MuonPi/cosmic-detector-unit-lite/README.md

# cosmic-detector-unit-lite

simplified version of the Muonpi-HAT-Board

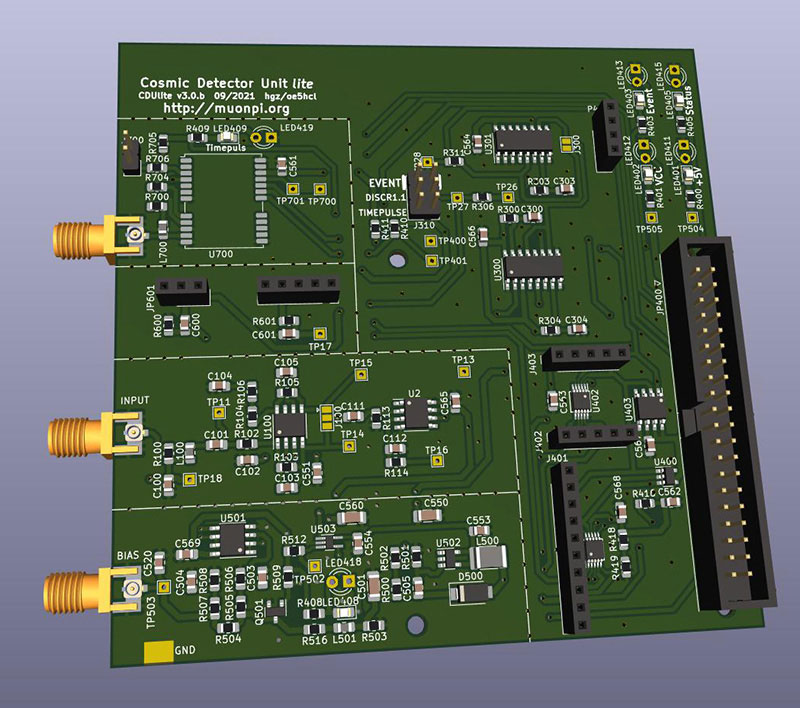
[picture p1: images/cdu-lite-3_0_b-1.jpg]
cdu-lite 3.0


License CC-BY-SA 3.0
