MuonPi/cosmic-detector-unit-lite/images/cdu-lite-3_0_b-2.jpg

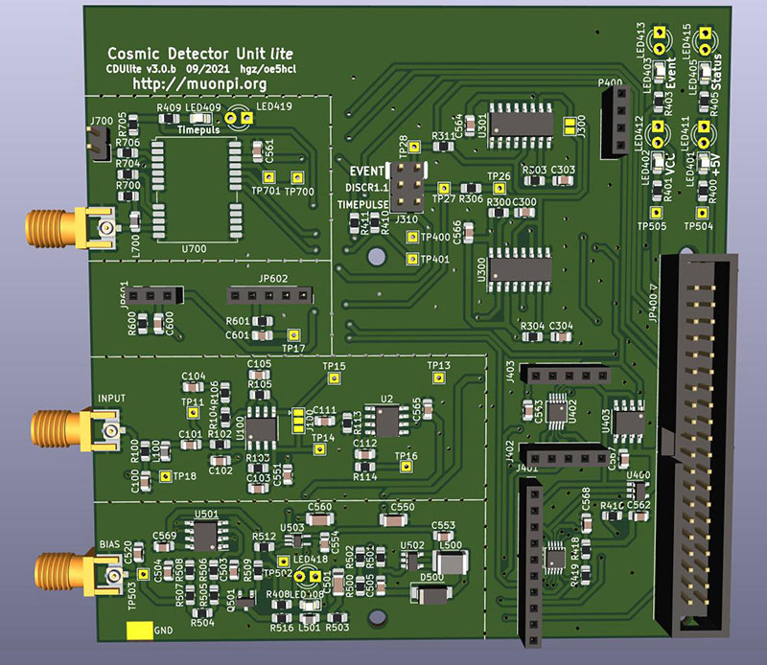
images/cdu-lite-3_0_b-2.jpg
