MuonPi/cosmic-detector-unit-lite/bom.xlsx

Sheet: cdu-lite Notes
BOM for the Cosmic Detector Unite Lite v3.0.b 11/2021
Some of the components were assembled by JLCpcb during production.
These components can be found in the list "cdu-lite parts Placed by JLC".
The remaining components can be found in the list "cdu-lite final assembly"
Additional Component which you need to operate the Muon Detector are listed in "additional components"

Sheet: cdu-lite Parts Placed by JLC
Ref | Qnty | Value | Footprint | Supplier | OriginalType | Preplaces By JLC | JLC Type | JLC Part Number
C100 C102 C112 C304 C551 C553 C554 C561 C562 C563 C564 C565 C566 C567 C569 | 15 | 100n | Capacitor_SMD:C_0805_2012Metric_Pad1.18x1.45mm_HandSolder | LCSC | FN21X104K500PXG | yes | CC0805KRX7R9BB104 | C49678
C101 C104 | 2 | 220p | Capacitor_SMD:C_0805_2012Metric_Pad1.18x1.45mm_HandSolder | LCSC | TCC0805X7R221K500DT | yes | CL21B221KBANNNC | C53172
C103 C105 | 2 | 2p2 | Capacitor_SMD:C_0805_2012Metric_Pad1.18x1.45mm_HandSolder | LCSC | TCC0805COG2R2C500BT | yes | 0805CG2R2C500NT | C1801
C111 C520 C600 C601 | 4 | 10n | Capacitor_SMD:C_0805_2012Metric_Pad1.18x1.45mm_HandSolder | LCSC | GRM216R71H103KA01D | yes | CL21B103KBANNNC | C1710
C300 | 1 | 33p | Capacitor_SMD:C_0805_2012Metric_Pad1.18x1.45mm_HandSolder | LCSC | TCC0805COG330J500BT | yes | CL21C330JBANNNC | C1814
C303 C503 C504 | 3 | 1n | Capacitor_SMD:C_0805_2012Metric_Pad1.18x1.45mm_HandSolder | LCSC | 0805B102K500CT | yes | CL21B102KBCNNNC | C46653
C501 C550 C560 | 3 | 4u7/50V X7R | Capacitor_SMD:C_1206_3216Metric_Pad1.33x1.80mm_HandSolder | LCSC | GRM31CR71H475KA12L | yes | 1206B475K500NT | C29823
C505 | 1 | 150p | Capacitor_SMD:C_0805_2012Metric_Pad1.18x1.45mm_HandSolder | LCSC | TCC0805X7R151K500BT | yes | 0805B151K500NT | C1716
C568 | 1 | 1u | Capacitor_SMD:C_0805_2012Metric_Pad1.18x1.45mm_HandSolder | LCSC | CL21B105KBFNNNE | yes | CL21B105KBFNNNE | C28323
L700 | 1 | 27nH | Inductor_SMD:L_0805_2012Metric_Pad1.15x1.40mm_HandSolder | LCSC | VHF201209H27NJT | yes | MLI2012-27N(f) | C56586
LED401 | 1 | +5V (yellow) | LED_SMD:LED_0805_2012Metric_Pad1.15x1.40mm_HandSolder | LCSC | E6C0805UYAC1UDA | yes | C2296 (yellow) | C2297
LED402 | 1 | VCC (yellow) | LED_SMD:LED_0805_2012Metric_Pad1.15x1.40mm_HandSolder | LCSC | E6C0805UYAC1UDA | yes | C2296 (yellow) | C2297
LED403 | 1 | CH1 (blue) | LED_SMD:LED_0805_2012Metric_Pad1.15x1.40mm_HandSolder | LCSC | 17-21/BHC-XL2M2TY/3T | yes | C2293 (red) | C84256
LED405 | 1 | St1 (green) | LED_SMD:LED_0805_2012Metric_Pad1.15x1.40mm_HandSolder | LCSC | ORH-G35A | yes | C2297 (green) | C2297
LED408 | 1 | BiasEn (red) | LED_SMD:LED_0805_2012Metric_Pad1.15x1.40mm_HandSolder | LCSC | 17-21SURC/S530-A3/TR8 | yes | NCD0805R1 (red) | C84256
LED409 | 1 | TimeP (white) | LED_SMD:LED_0805_2012Metric_Pad1.15x1.40mm_HandSolder | LCSC | ORH-W45A | yes | C34499 (white) | C84256
Q501 | 1 | 2N7002 | Package_TO_SOT_SMD:SOT-23 | LCSC | C8545 | yes | 2N7002 | C8545
R100 R306 R311 R705 R706 | 5 | 51R | Resistor_SMD:R_0805_2012Metric_Pad1.20x1.40mm_HandSolder | LCSC | CR0805J80510G | yes | 0805W8F510JT5E | C17738
R102 R104 R300 R303 R601 | 5 | 1k | Resistor_SMD:R_0805_2012Metric_Pad1.20x1.40mm_HandSolder | LCSC | AR05FTDW1001 | yes | 0805W8F1001T5E | C17513
R103 R105 R400 R403 | 4 | 2k7 | Resistor_SMD:R_0805_2012Metric_Pad1.20x1.40mm_HandSolder | LCSC | RS-05K2701FT | yes | 0805W8F2701T5E | C17530
R106 | 1 | 27R | Resistor_SMD:R_0805_2012Metric_Pad1.20x1.40mm_HandSolder | LCSC | CR0805F827R0G | yes | 0805W8F270JT5E | C17594
R113 R418 R419 R504 R509 R512 R516 R600 | 8 | 10k | Resistor_SMD:R_0805_2012Metric_Pad1.20x1.40mm_HandSolder | LCSC | WR08X1002FTL | yes | 0805W8F1002T5E | C17414
R114 | 1 | 100 | Resistor_SMD:R_0805_2012Metric_Pad1.20x1.40mm_HandSolder | LCSC | 0805W8F1000T5E | yes | 0805W8F1000T5E | C17408
R304 | 1 | 470k | Resistor_SMD:R_0805_2012Metric_Pad1.20x1.40mm_HandSolder | LCSC | RS-05K4703FT | yes | 0805W8F4703T5E | C17709
R401 | 1 | 1k8 | Resistor_SMD:R_0805_2012Metric_Pad1.20x1.40mm_HandSolder | LCSC | -- | yes | 0805W8F1801T5E | C17398
R405 R409 | 2 | 3k6 | Resistor_SMD:R_0805_2012Metric_Pad1.20x1.40mm_HandSolder | LCSC | -- | yes | 0805W8F3601T5E | C18359
R408 | 1 | 2k2 | Resistor_SMD:R_0805_2012Metric_Pad1.20x1.40mm_HandSolder | LCSC | -- | yes | 0805W8F2201T5E | C17520
R410 R411 R416 R503 | 4 | 4k7 | Resistor_SMD:R_0805_2012Metric_Pad1.20x1.40mm_HandSolder | LCSC | RK73B2ATTD472J | yes | 0805W8F4701T5E | C17673
R500 | 1 | 220k | Resistor_SMD:R_0805_2012Metric_Pad1.20x1.40mm_HandSolder | LCSC | RS-05K224JT | yes | 0805W8F2203T5E | C17556
R501 | 1 | 13k | Resistor_SMD:R_0805_2012Metric_Pad1.20x1.40mm_HandSolder | LCSC | 0805W8F1302T5E | yes | 0805W8F1302T5E | C17455
R502 | 1 | 22k | Resistor_SMD:R_0805_2012Metric_Pad1.20x1.40mm_HandSolder | LCSC | 0805W8F2202T5E | yes | 0805W8F2202T5E | C17560
R505 R507 | 2 | 10M | Resistor_SMD:R_0805_2012Metric_Pad1.20x1.40mm_HandSolder | LCSC | RTT051005FTP | yes | 0805W8F1005T5E | C26108
R506 R508 | 2 | 1M | Resistor_SMD:R_0805_2012Metric_Pad1.20x1.40mm_HandSolder | LCSC | RS-05K1004FT | yes | 0805W8F1004T5E | C17514
R700 | 1 | 10R | Resistor_SMD:R_0805_2012Metric_Pad1.20x1.40mm_HandSolder | LCSC | RK73H2ATTD10R0F | yes | 0805W8F100JT5E | C17415
R704 | 1 | 0R | Resistor_SMD:R_0805_2012Metric_Pad1.20x1.40mm_HandSolder | LCSC | -- | yes | 0805W8F0000T5E | C17477
U100 | 1 | LMH6550MAX_NOPE | muonpi-kicad-library:SOIC-8_3.9x4.9mm_P1.27mm | LCSC | 926-LMH6550MAX/NOPB | yes | LMH6550MA/NOPB | C205894
U403 | 1 | LM75BIM-3 | Package_SO:SOIC-8_3.9x4.9mm_P1.27mm | LCSC | C34565 | yes | M75BD,118 | C34565
U502 | 1 | LM2733YMFX/NOPB | Package_TO_SOT_SMD:SOT-23-5 | LCSC | LM2733YMFX/NOPB | yes | LM2733YMFX/NOPB | C527399

Sheet: cdu-lite final assembly
Ref |  | Qnty | Value | Footprint | Supplier | Type
L100 L501 |  | 2 | 1uH | Inductor_SMD:L_0805_2012Metric_Pad1.15x1.40mm_HandSolder | Mouser | L-15F1R0JV4E
L500 |  | 1 | 10uH | Inductor_SMD:L_1812_4532Metric_Pad1.30x3.40mm_HandSolder | Mouser | LQH43MN100J03L
U2 |  | 1 | TLV3501AID | Package_SO:SOIC-8_3.9x4.9mm_P1.27mm | Mouser | 595-TLV3501AID
U300 U301 |  | 2 | SN74LV221AD | Package_SO:SOIC-16_3.9x9.9mm_P1.27mm | Mouser | 595-SN74LV221ADR
U400 |  | 1 | 24AA02UIDT-IOT | Package_TO_SOT_SMD:SOT-23-5 | Mouser | 579-24AA02UIDT-I/OT
U501 |  | 1 | MCP6L02x-xSN | Package_SO:SOIC-8_3.9x4.9mm_P1.27mm | Mouser | 579-MCP6L02T-E/SN
U503 |  | 1 | TPS22944DCKR | Package_TO_SOT_SMD:SOT-353_SC-70-5_Handsoldering | Mouser | 595-TPS22944DCKR
U700 |  | 1 | ublox NEO-6P | muonpi-kicad-library:ublox_NEO | -- |  | Note: NEO-6/7/8/9 are pin compatible und supported.
X1 X5 |  | 2 | Conn_Coaxial | muonpi-kicad-library:Connector_Coaxial_SMA_edge_combined | LCSC | U.FL-R-SMT-1(80)
J310 |  | 1 | Conn_02x03_Odd_Even | Connector_PinHeader_2.54mm:PinHeader_2x03_P2.54mm_Vertical | Mouser | 649-1012938190601BLF
to J310 |  | 1 | Jumper RM 2.54 |  | Mouser | 861410021H12LF
X7 |  | 1 | U.FL-R-SMT-1(80) | muonpi-kicad-library:Connector_Coaxial_SMA_edge_combined | LCSC | U.FL-R-SMT-1(80)
 | or | 1 | SMA Female |  | -- | SMA Female Connector for PCB Edge Mount
D500 |  | 1 | MBRA160T3G | Diode_SMD:D_SMA | LCSC | MBRA160T3G
 | or | 1 | B160AF-13 | Diode_SMD:D_SMA | Mouser | B160AF-13
JP400 |  | 1 | ICD Header 2x20 RM 2.54 | Connector_IDC:IDC-Header_2x20_P2.54mm_Vertical | --
 | or | 1 | Conn_02x20 | Connector_PinSocket_2.54mm:PinSocket_2x20_P2.54mm_Vertical | --
U401 |  | 1 | ADS1015IDGSR | Package_SO:TSSOP-10_3x3mm_P0.5mm | Mouser | 595-ADS1015IDGSR
 | or
J401 |  | 1 | Conn_01x10_Female | Connector_PinSocket_2.54mm:PinSocket_1x10_P2.54mm_Vertical | --
U401 breakout |  | 1 | ADS1015 Breakout Board
U402 |  | 1 | MCP4728_EUN | Package_SO:MSOP-10_3x3mm_P0.5mm | Mouser | 579-MCP4728-E/UN
 | or
J402 J403 |  | 2 | Conn_01x06_Female | Connector_PinSocket_2.54mm:PinSocket_1x06_P2.54mm_Vertical | --
U402 breakout |  | 1 | Adafruit MCP4728 Breakout
optional if you want to use a I2C Oled Display
P400 |  | 1 | Conn_01x04_Female | Connector_PinSocket_2.54mm:PinSocket_1x04_P2.54mm_Vertical | --
 |  | 1 | I2C Oled Display
optional if you want to add a Peak Detector
JP601 |  | 1 | Conn_01x03_Female | Connector_PinSocket_2.54mm:PinSocket_1x03_P2.54mm_Vertical | --
JP602 |  | 1 | Conn_01x05_Female | Connector_PinSocket_2.54mm:PinSocket_1x05_P2.54mm_Vertical | --

Sheet: Aditional components
qty | Description
1 | Raspberry Pi with 40 Pin GPIO Header (e.g. Raspberry Pi 3 or 4 // Raspberry Pi Zero (W))
1 | SD Card for Raspberry Pi (with Raspberry PI OS recommended)
1 | Power Supply for Raspberry Pi
1 | GPS Antenna
1 | 40 pin ribbon-cable with 2x20 RM2.54 female connector
1 | Scintillation detector from the Muonpi Project
2 | U.FL -> U.FL female cable
