MuonPi/cosmic-detector-unit-lite/pdf/cdu-lite.pdf

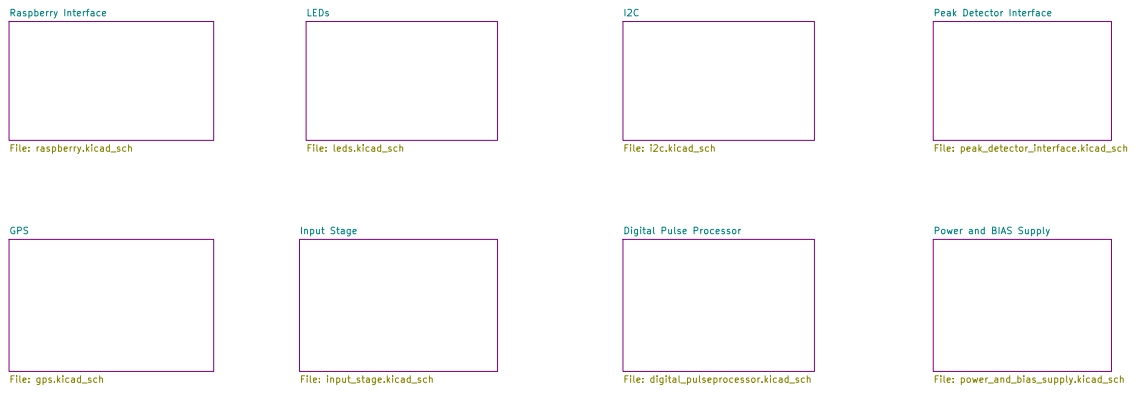
[picture p3: page 1]

Power and BIAS Supply

File: cdu-lite.kicad_sch Sheet: /
Id: 1/9 Title:

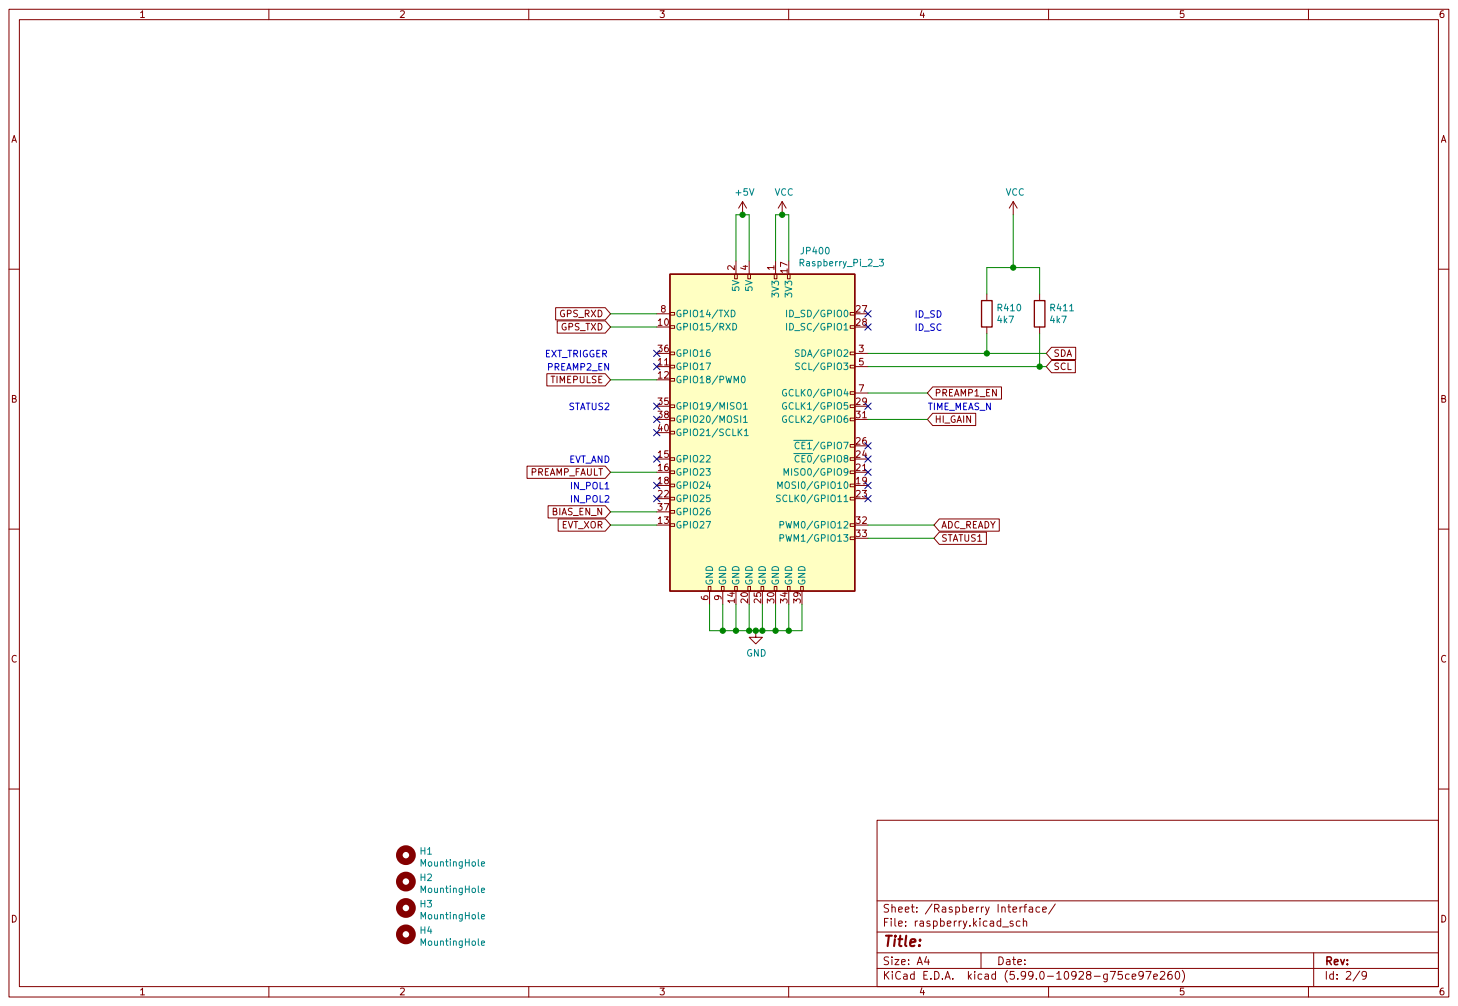
[picture p4: page 2]

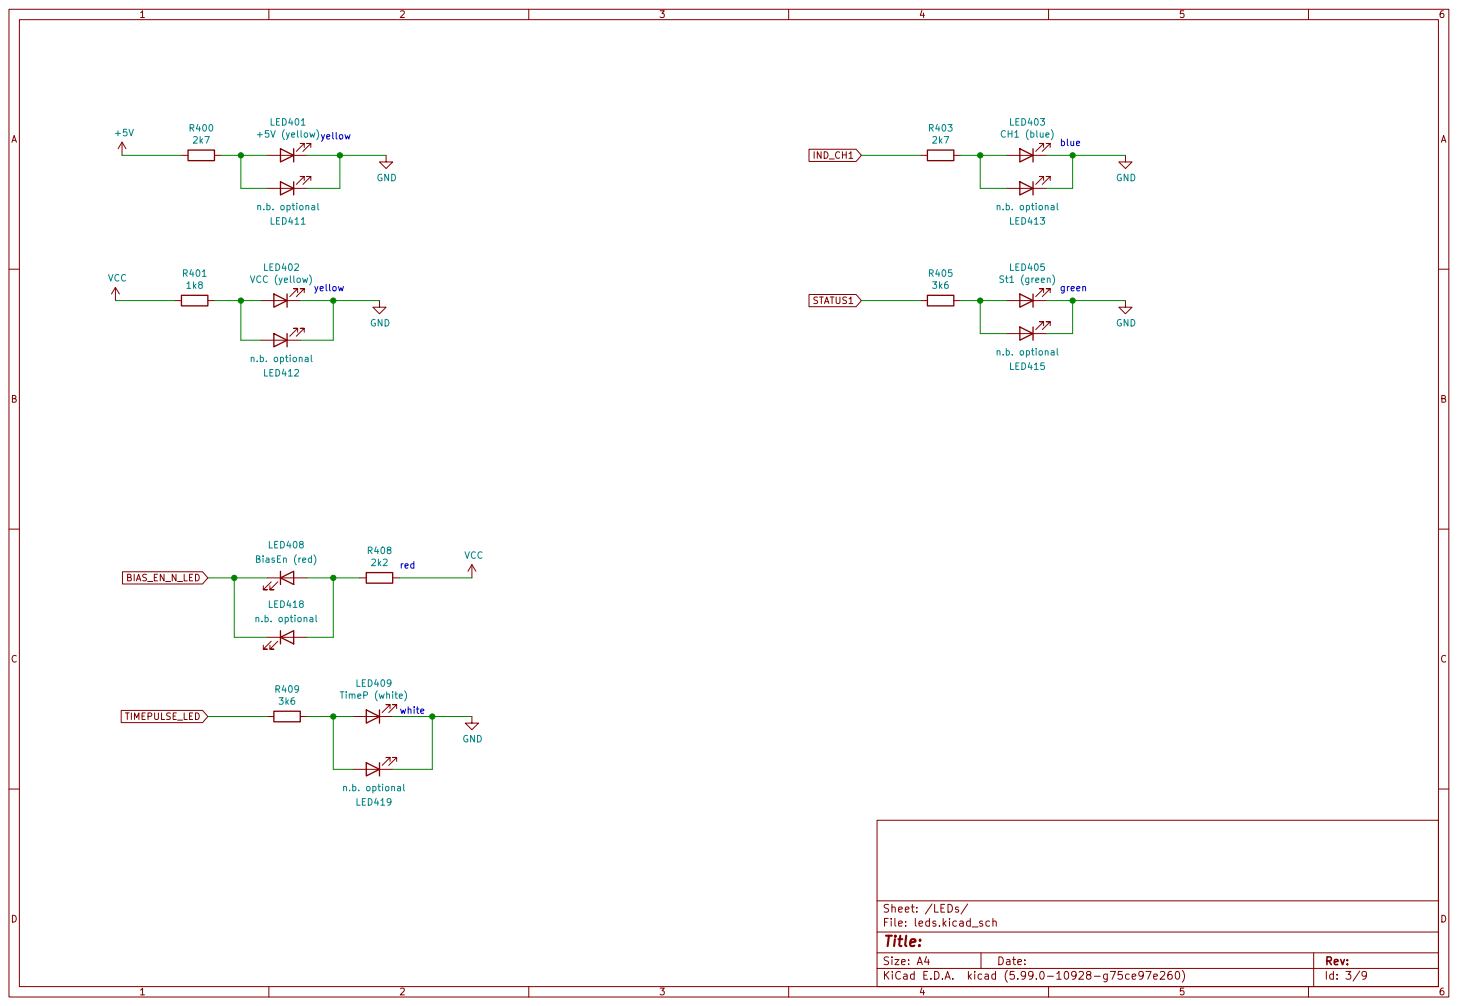
[picture p5: page 3]

File: leds.kicad_sch Sheet: /LEDs/
Id: 3/9 Title:

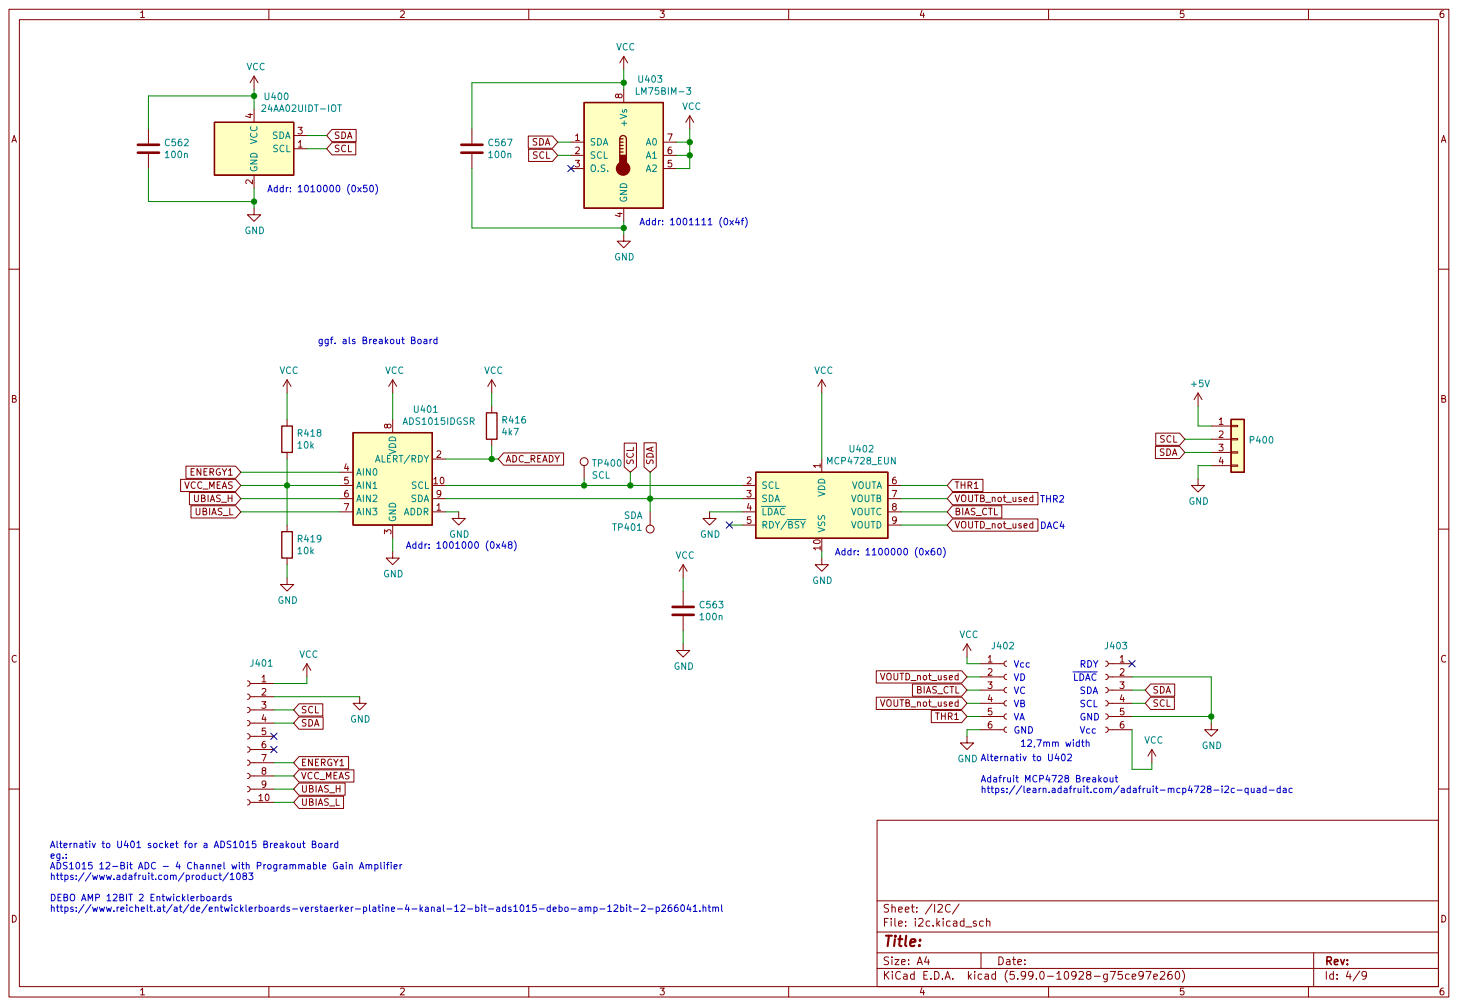
[picture p6: page 4]

1 VSS 10 SCL 2 SDA 3 ~LDAC 4 RDY/~BSY 5 VOUTA 6 VOUTB 7 VOUTC 8 VOUTD 9 U402 MCP4728_EUN GND GND

Alternativ to U401 socket for a ADS1015 Breakout Board
eg.: ADS1015 12-Bit ADC - 4 Channel with Programmable Gain Amplifier

https://www.adafruit.com/product/1083 DEBO AMP 12BIT 2 Entwicklerboards https://www.reichelt.at/at/de/entwicklerboards-verstaerker-platine-4-kanal-12-bit-ads1015-debo-amp-12bit-2-p266041.html

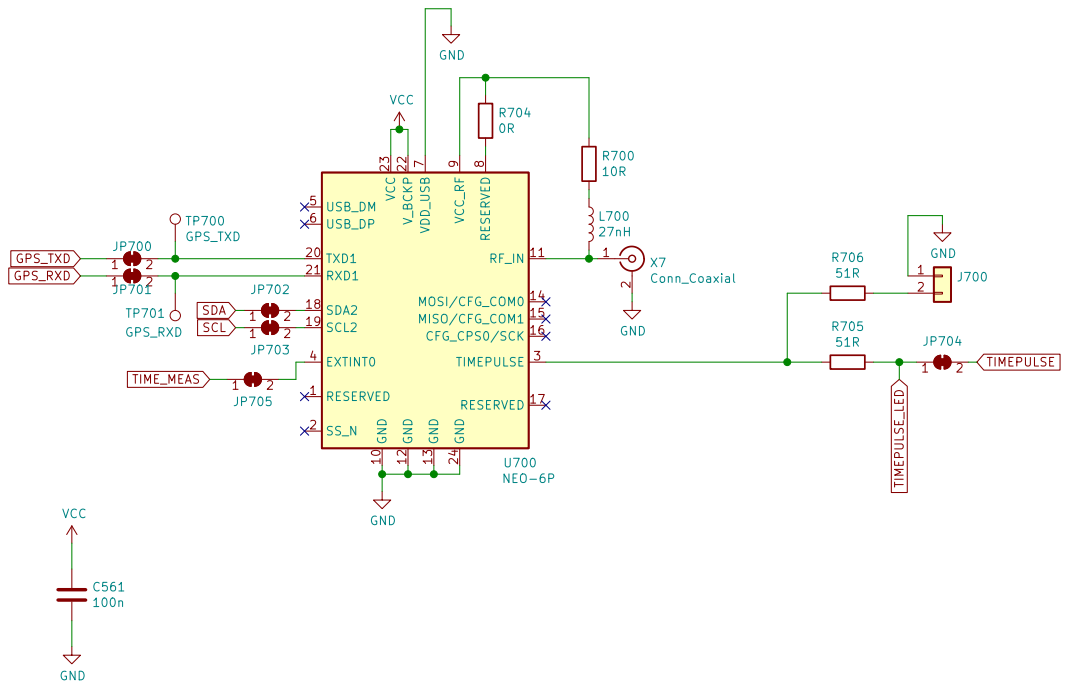
[picture p7: page 5]

File: gps.kicad_sch Sheet: /GPS/
Id: 5/9 Title:

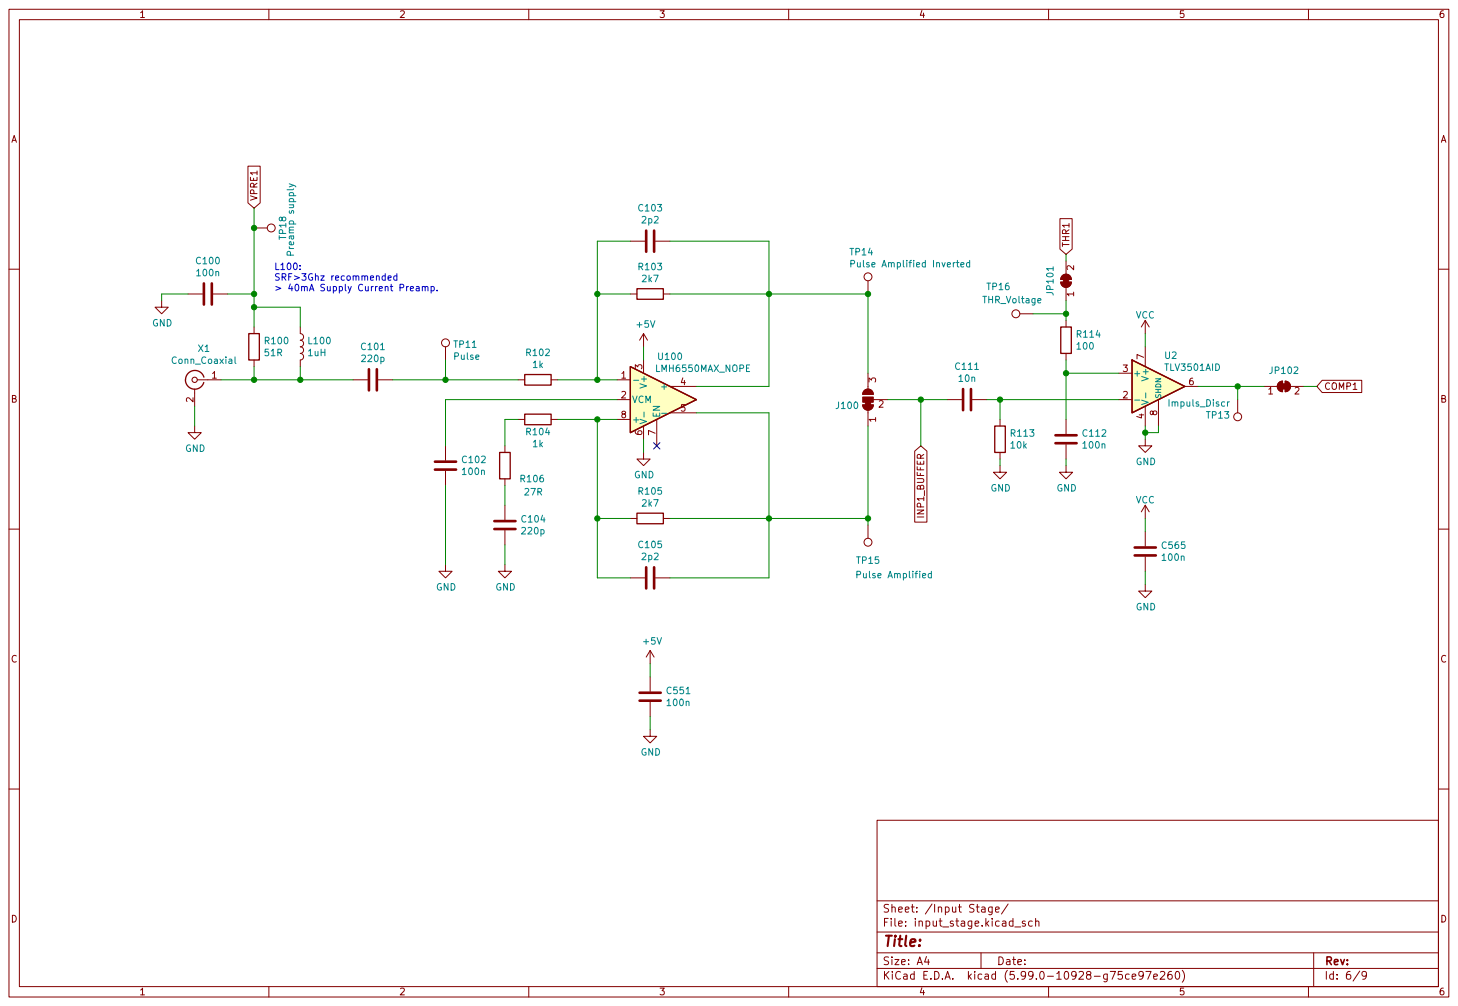
[picture p8: page 6]

L100: SRF>3Ghz recommended > 40mA Supply Current Preamp.

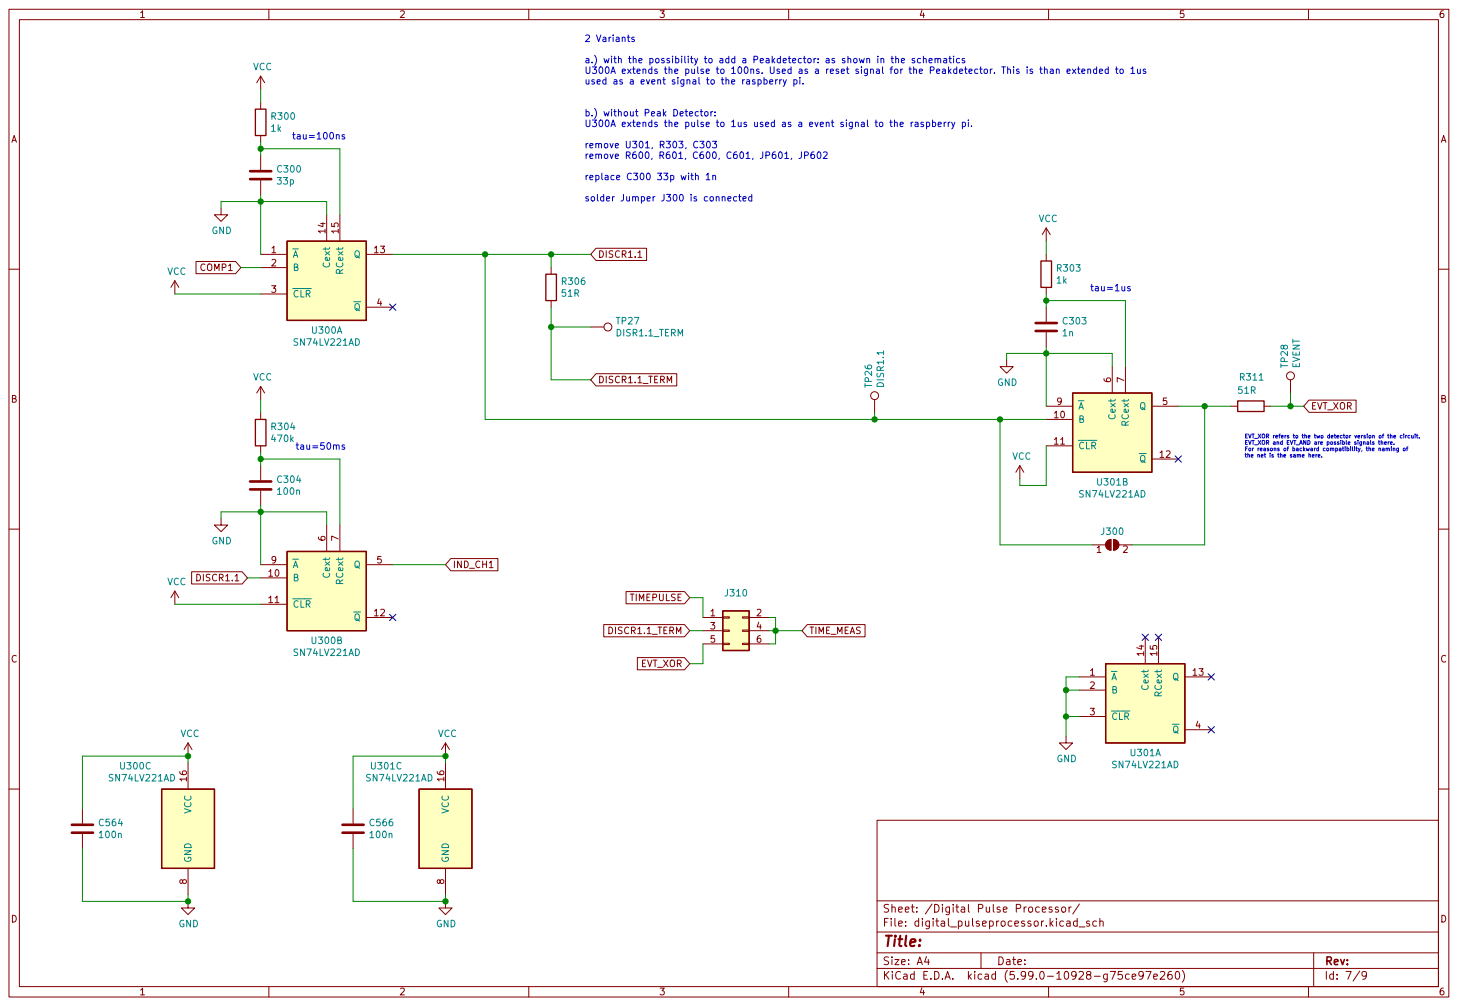
[picture p9: page 7]

the net is the same here. tau=1us 2 Variants a.) with the possibility to add a Peakdetector: as shown in the schematics

U300A extends the pulse to 100ns. Used as a reset signal for the Peakdetector. This is than extended to 1us
used as a event signal to the raspberry pi.
SN74LV221AD GND

b.) without Peak Detector:
U300A extends the pulse to 1us used as a event signal to the raspberry pi. remove U301, R303, C303

solder Jumper J300 is connected

EVT_XOR refers to the two detector version of the circuit. EVT_XOR and EVT_AND are possible signals there. For reasons of backward compatibility, the naming of

Sheet: /Digital Pulse Processor/ GND

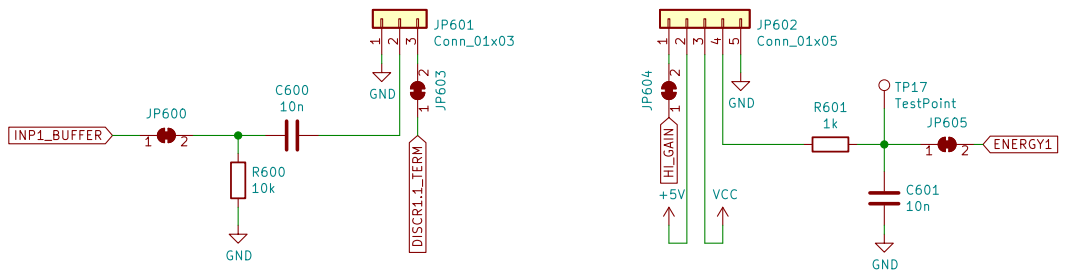
[picture p10: page 8]

File: peak_detector_interface.kicad_sch Sheet: /Peak Detector Interface/
Id: 8/9 Title:

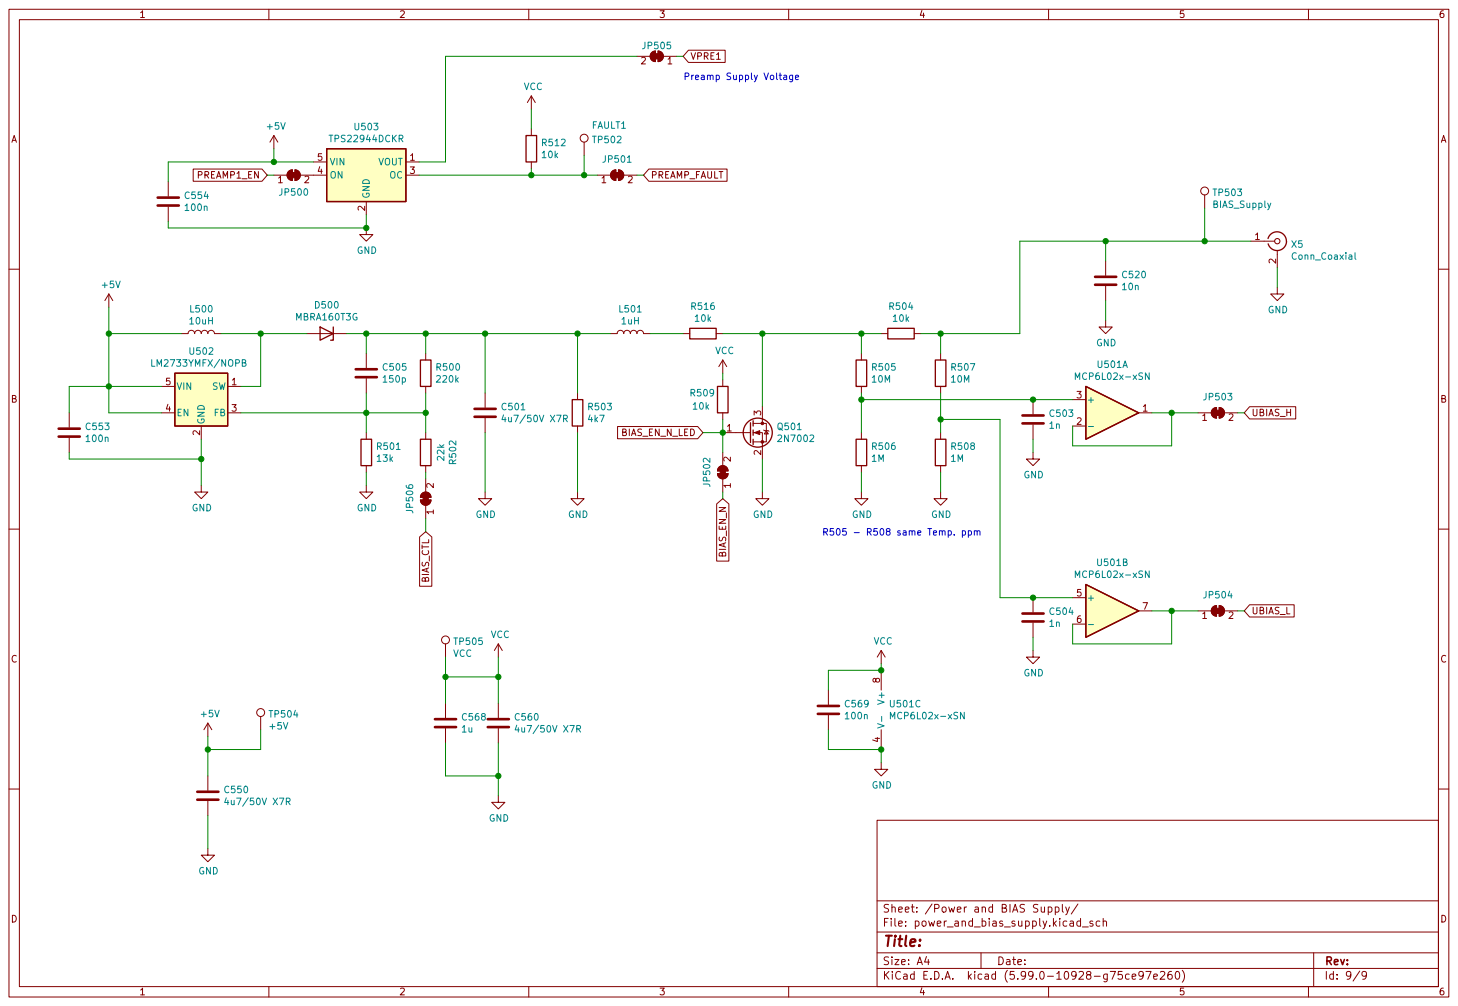
[picture p11: page 9]

Sheet: /Power and BIAS Supply/
File: power_and_bias_supply.kicad_sch
Id: 9/9 Title:
