MuonPi/cosmic-detector-unit-lite/(commit log)

2021-06-01 Updated footprint library to latest commit
2021-06-02 Added all project files
    [cdu-lite.kicad_pcb, cdu-lite.kicad_sch, digital_pulseprocessor.kicad_sch, gps.kicad_sch, i2c.kicad_sch, input_stage.kicad_sch, leds.kicad_sch, pead_detector_interface.kicad_sch]
2021-06-14 Changes in BOM. Add JLCpcb Part Nr
    [cdu-lite.kicad_sch, digital_pulseprocessor.kicad_sch, gps.kicad_sch, i2c.kicad_sch, input_stage.kicad_sch, leds.kicad_sch, pead_detector_interface.kicad_sch, power_and_bias_supply.kicad_sch]
2021-06-14 Minor Fixes
    [cdu-lite.kicad_sch, digital_pulseprocessor.kicad_sch, i2c.kicad_sch, input_stage.kicad_sch, pead_detector_interface.kicad_sch, power_and_bias_supply.kicad_sch]
2021-06-15 working on BOM. Small Fixes in Schematics
    [cdu-lite.kicad_sch, digital_pulseprocessor.kicad_sch, gps.kicad_sch, input_stage.kicad_sch, pead_detector_interface.kicad_sch, power_and_bias_supply.kicad_sch, raspberry.kicad_sch]
2021-06-22 Footprints assigned. Testpoints added
    [cdu-lite.kicad_sch, digital_pulseprocessor.kicad_sch, gps.kicad_sch, i2c.kicad_sch, input_stage.kicad_sch, leds.kicad_sch, pead_detector_interface.kicad_sch, power_and_bias_supply.kicad_sch]
2021-06-29 Changed the position of the capacitor in the circuit diagram. Capacitors are now close to the components as on the circuit board.
    [cdu-lite.kicad_sch, digital_pulseprocessor.kicad_sch, gps.kicad_sch, i2c.kicad_sch, input_stage.kicad_sch, power_and_bias_supply.kicad_sch]
2021-06-30 Started PCB. Placed Parts
    [cdu-lite.kicad_pcb, cdu-lite.kicad_sch, i2c.kicad_sch, leds.kicad_sch, pead_detector_interface.kicad_sch, power_and_bias_supply.kicad_sch, raspberry.kicad_sch]
2021-06-30 Changes U2 from TLV3502 to TLV3501
    [cdu-lite.kicad_pcb, cdu-lite.kicad_sch, input_stage.kicad_sch]
2021-07-05 Progress in PCB. Some changes in Schematis. Solderjumper for modular design added.
    [cdu-lite.kicad_pcb, cdu-lite.kicad_sch, gps.kicad_sch, input_stage.kicad_sch, power_and_bias_supply.kicad_sch, raspberry.kicad_sch]
2021-07-05 Removed optionals parts. Cleaned up Schematics
    [cdu-lite.kicad_pcb, cdu-lite.kicad_sch, digital_pulseprocessor.kicad_sch, gps.kicad_sch, i2c.kicad_sch, input_stage.kicad_sch, pead_detector_interface.kicad_sch]
2021-07-07 Rough routing finished
    [cdu-lite.kicad_pcb, cdu-lite.kicad_sch, gps.kicad_sch, leds.kicad_sch]
2021-07-08 Cleand all errors and warnings. Ready for review
    [cdu-lite.kicad_pcb, cdu-lite.kicad_sch, digital_pulseprocessor.kicad_sch]
2021-07-08 Added PDF for Schematics
2021-07-08 Silkscreen edided. Minor improvements
    [cdu-lite.kicad_pcb, cdu-lite.kicad_sch, i2c.kicad_sch, peak_detector_interface.kicad_sch, raspberry.kicad_sch]
2021-07-12 minor changes on pcb. cleaning up design rule errors
    [cdu-lite.kicad_pcb, cdu-lite.kicad_sch, i2c.kicad_sch]
2021-07-20 Notes added in Schematics. Vias added on PCB.
    [cdu-lite.kicad_pcb, cdu-lite.kicad_sch, digital_pulseprocessor.kicad_sch, input_stage.kicad_sch, power_and_bias_supply.kicad_sch]
2021-07-21 Redesign of Board. Added optional Breakoutboars for ADC and DAC
    [cdu-lite.kicad_pcb, cdu-lite.kicad_sch, i2c.kicad_sch, leds.kicad_sch, power_and_bias_supply.kicad_sch, raspberry.kicad_sch]
2021-07-21 Added LED Text. Moved optionals Display position
    [cdu-lite.kicad_pcb]
2021-08-05 redesign finished and optional 3mm LEDs added.
    [cdu-lite.kicad_pcb, cdu-lite.kicad_sch, leds.kicad_sch, power_and_bias_supply.kicad_sch]
2021-08-30 some changes after first test of boards. Package of SN74LV221AD changed to SOIC-16.
    [cdu-lite-jlc-bom.xlsx, cdu-lite.kicad_pcb, cdu-lite.kicad_sch, digital_pulseprocessor.kicad_sch, gps.kicad_sch, i2c.kicad_sch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]
2021-09-14 Updated library reference
    [cdu-lite.kicad_pcb, cdu-lite.kicad_sch, input_stage.kicad_sch]
2021-09-14 added Images
    [cdu-lite.kicad_pcb]
2021-10-17 Improved Silkscreen.
    [cdu-lite.kicad_pcb]
2021-10-19 Changed Breakoutboard for MCP4728 to Adafruit Board. Some improvements on pcb
    [cdu-lite.kicad_pcb, cdu-lite.kicad_sch, i2c.kicad_sch]
2021-11-23 prepare for jlc-pcb order
    [cdu-lite-B_Cu.gbr, cdu-lite-B_Mask.gbr, cdu-lite-B_Silkscreen.gbr, cdu-lite-Edge_Cuts.gbr, cdu-lite-F_Cu.gbr, cdu-lite-F_Mask.gbr, cdu-lite-F_Silkscreen.gbr, cdu-lite-NPTH.drl]
2021-11-26 KiCad update to 6.0.0-rc1-114-gb471945224
    [cdu-lite.kicad_pcb, cdu-lite.kicad_sch, digital_pulseprocessor.kicad_sch, gps.kicad_sch, i2c.kicad_sch, input_stage.kicad_sch, leds.kicad_sch, peak_detector_interface.kicad_sch]
2021-11-26 cleaned up design rules warnings on pcb
    [cdu-lite.kicad_pcb]
2022-01-05 update Kicad to 6.0.0
    [cdu-lite.kicad_sch, digital_pulseprocessor.kicad_sch, gps.kicad_sch, i2c.kicad_sch, input_stage.kicad_sch, leds.kicad_sch, peak_detector_interface.kicad_sch, power_and_bias_supply.kicad_sch]
2022-01-12 worked on bom. some changes. added license
    [bom.xlsx, digital_pulseprocessor.kicad_sch, gps.kicad_sch, i2c.kicad_sch, input_stage.kicad_sch, leds.kicad_sch, peak_detector_interface.kicad_sch, power_and_bias_supply.kicad_sch]
2022-01-13 Updated schematic and pcb to use global muonpi library
    [cdu-lite.kicad_pcb, cdu-lite.kicad_sch, gps.kicad_sch, input_stage.kicad_sch, power_and_bias_supply.kicad_sch]
